gt-marine-robotics-group/Microtransat-PCB/AS5600_Mockup/AS5600_Mockup.step

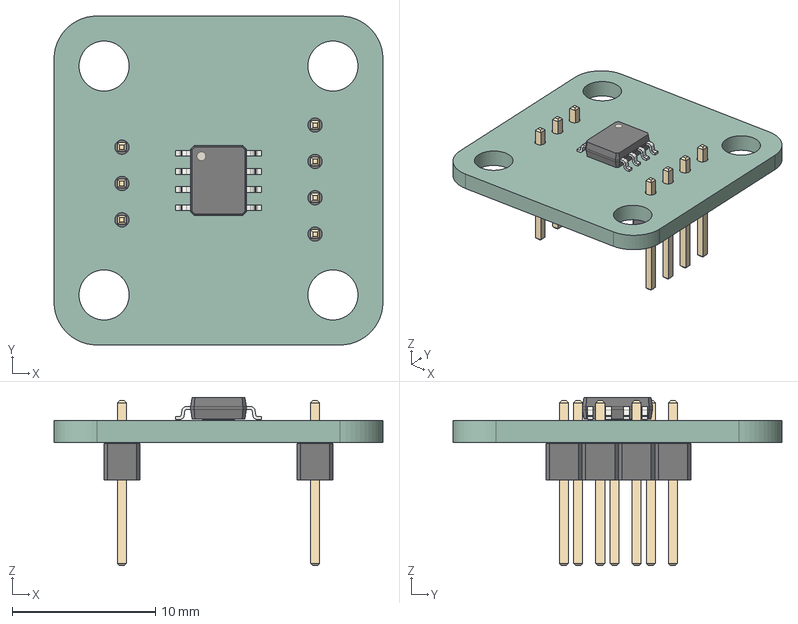
[picture p1: CAD file, 2026-02-19]
AS5600_Mockup/AS5600_Mockup.step
23.0 x 23.0 x 11.8 mm
SOIC-8-1EP_3.9x4.9mm_P1.27mm_EP2.29x3mm
PinHeader_1x04_P2.54mm_Vertical
PinHeader_1x03_P2.54mm_Vertical
AS5600_Mockup_PCB
