gt-marine-robotics-group/Microtransat-PCB/AS5600_Mockup/AS5600 Profile.dxf

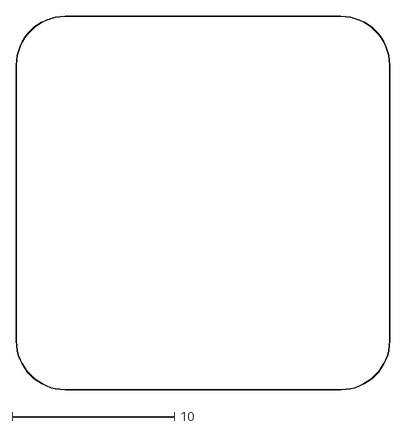
[picture p2: CAD file, 2026-02-19]
AS5600_Mockup/AS5600 Profile.dxf
23.0 x 23.0
