gt-marine-robotics-group/Microtransat-PCB/Microtransat_Schematic/Microtransat_Schematic.pdf

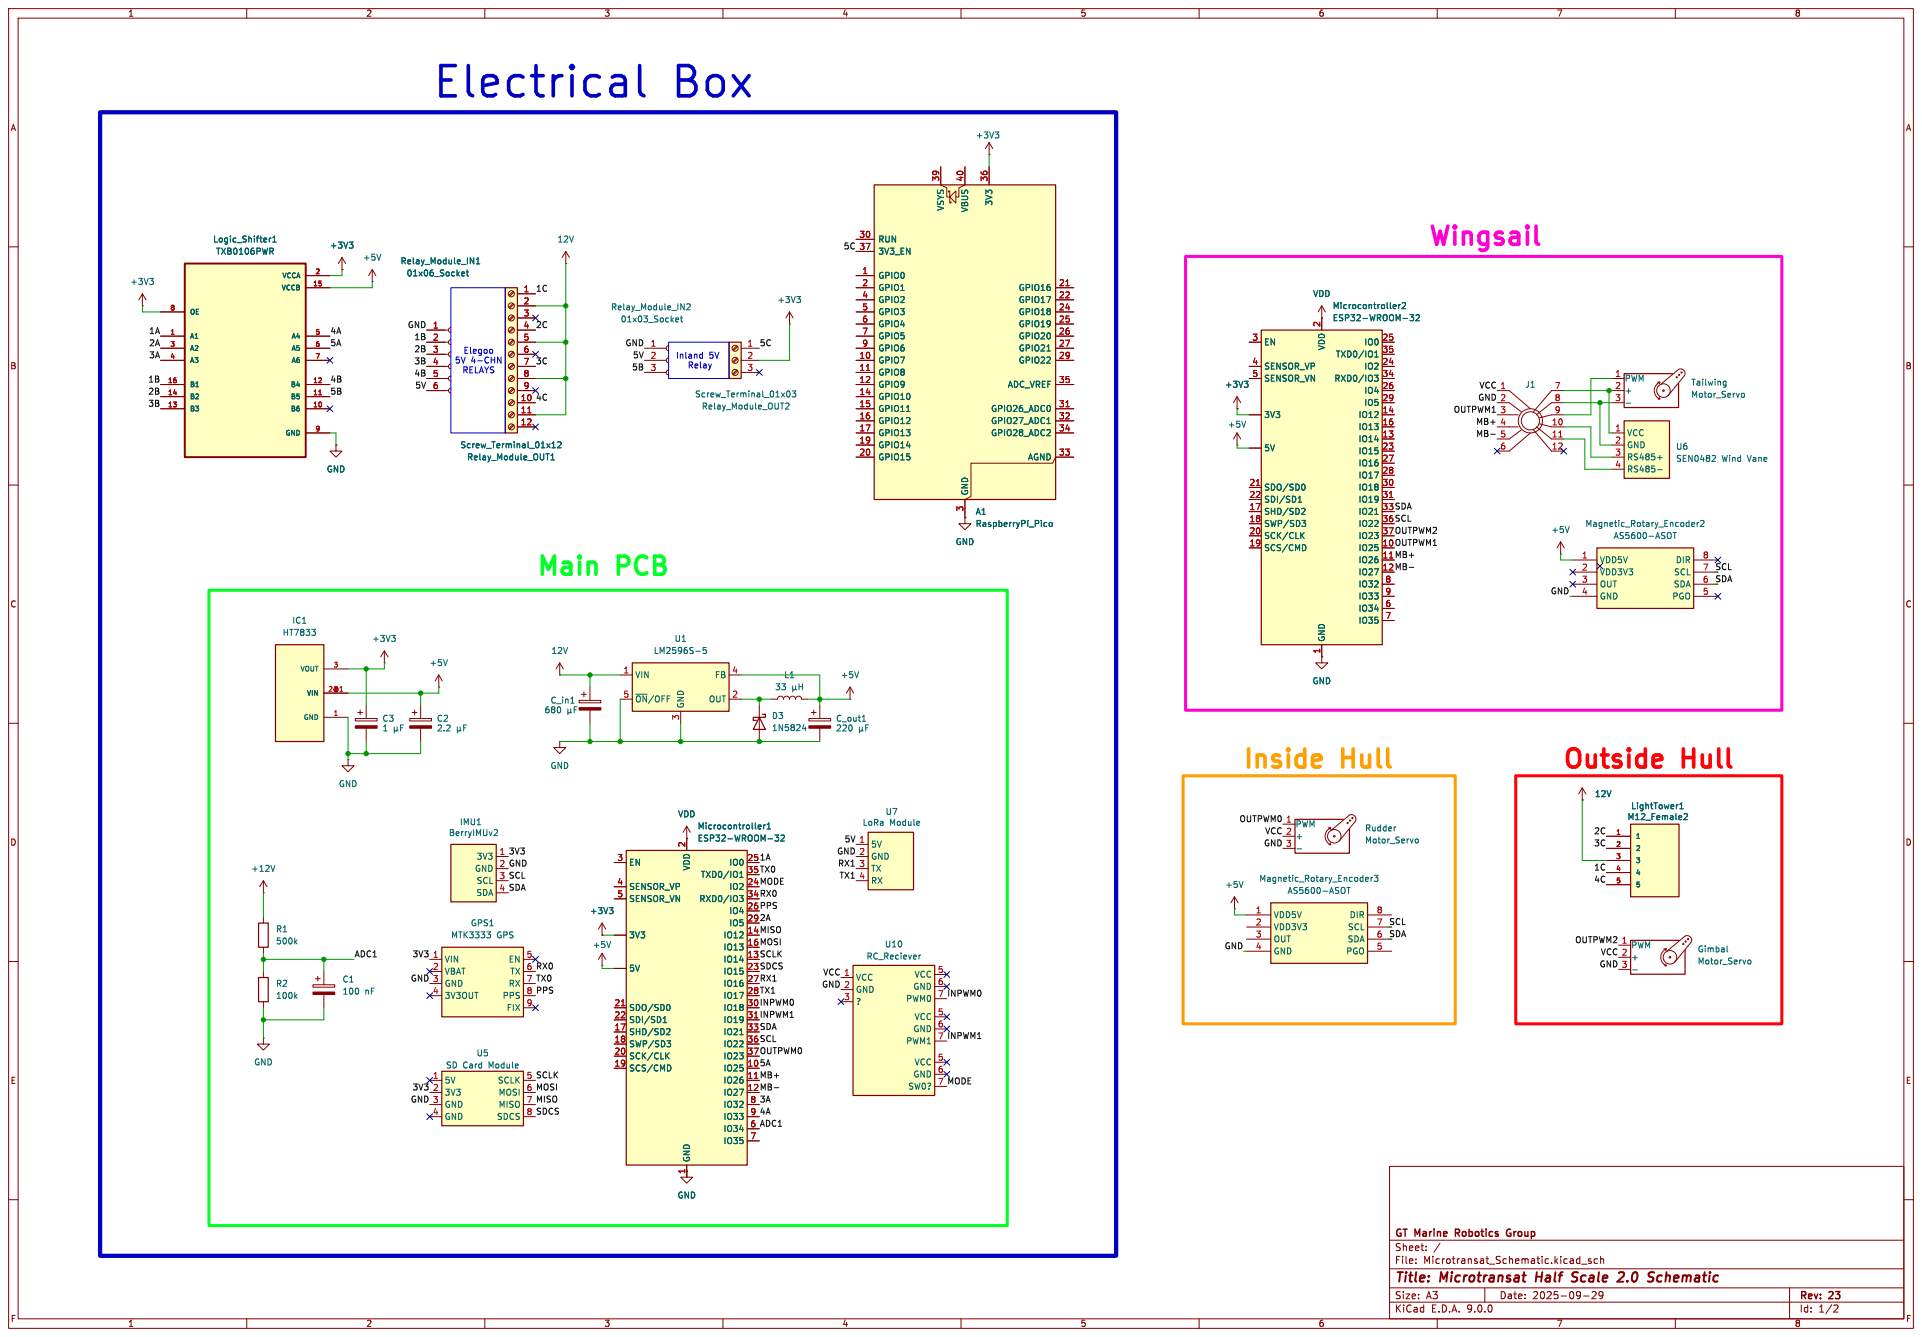
[picture p3: page 1]

Id: 1/2 Title: Microtransat Half Scale 2.0 Schematic
