gt-marine-robotics-group/Microtransat-PCB/Microtransat_mainboard/Microtransat_mainboard.kicad_pcb

## KiCad design Microtransat_mainboard/Microtransat_mainboard.kicad_pcb (2026-10-01)

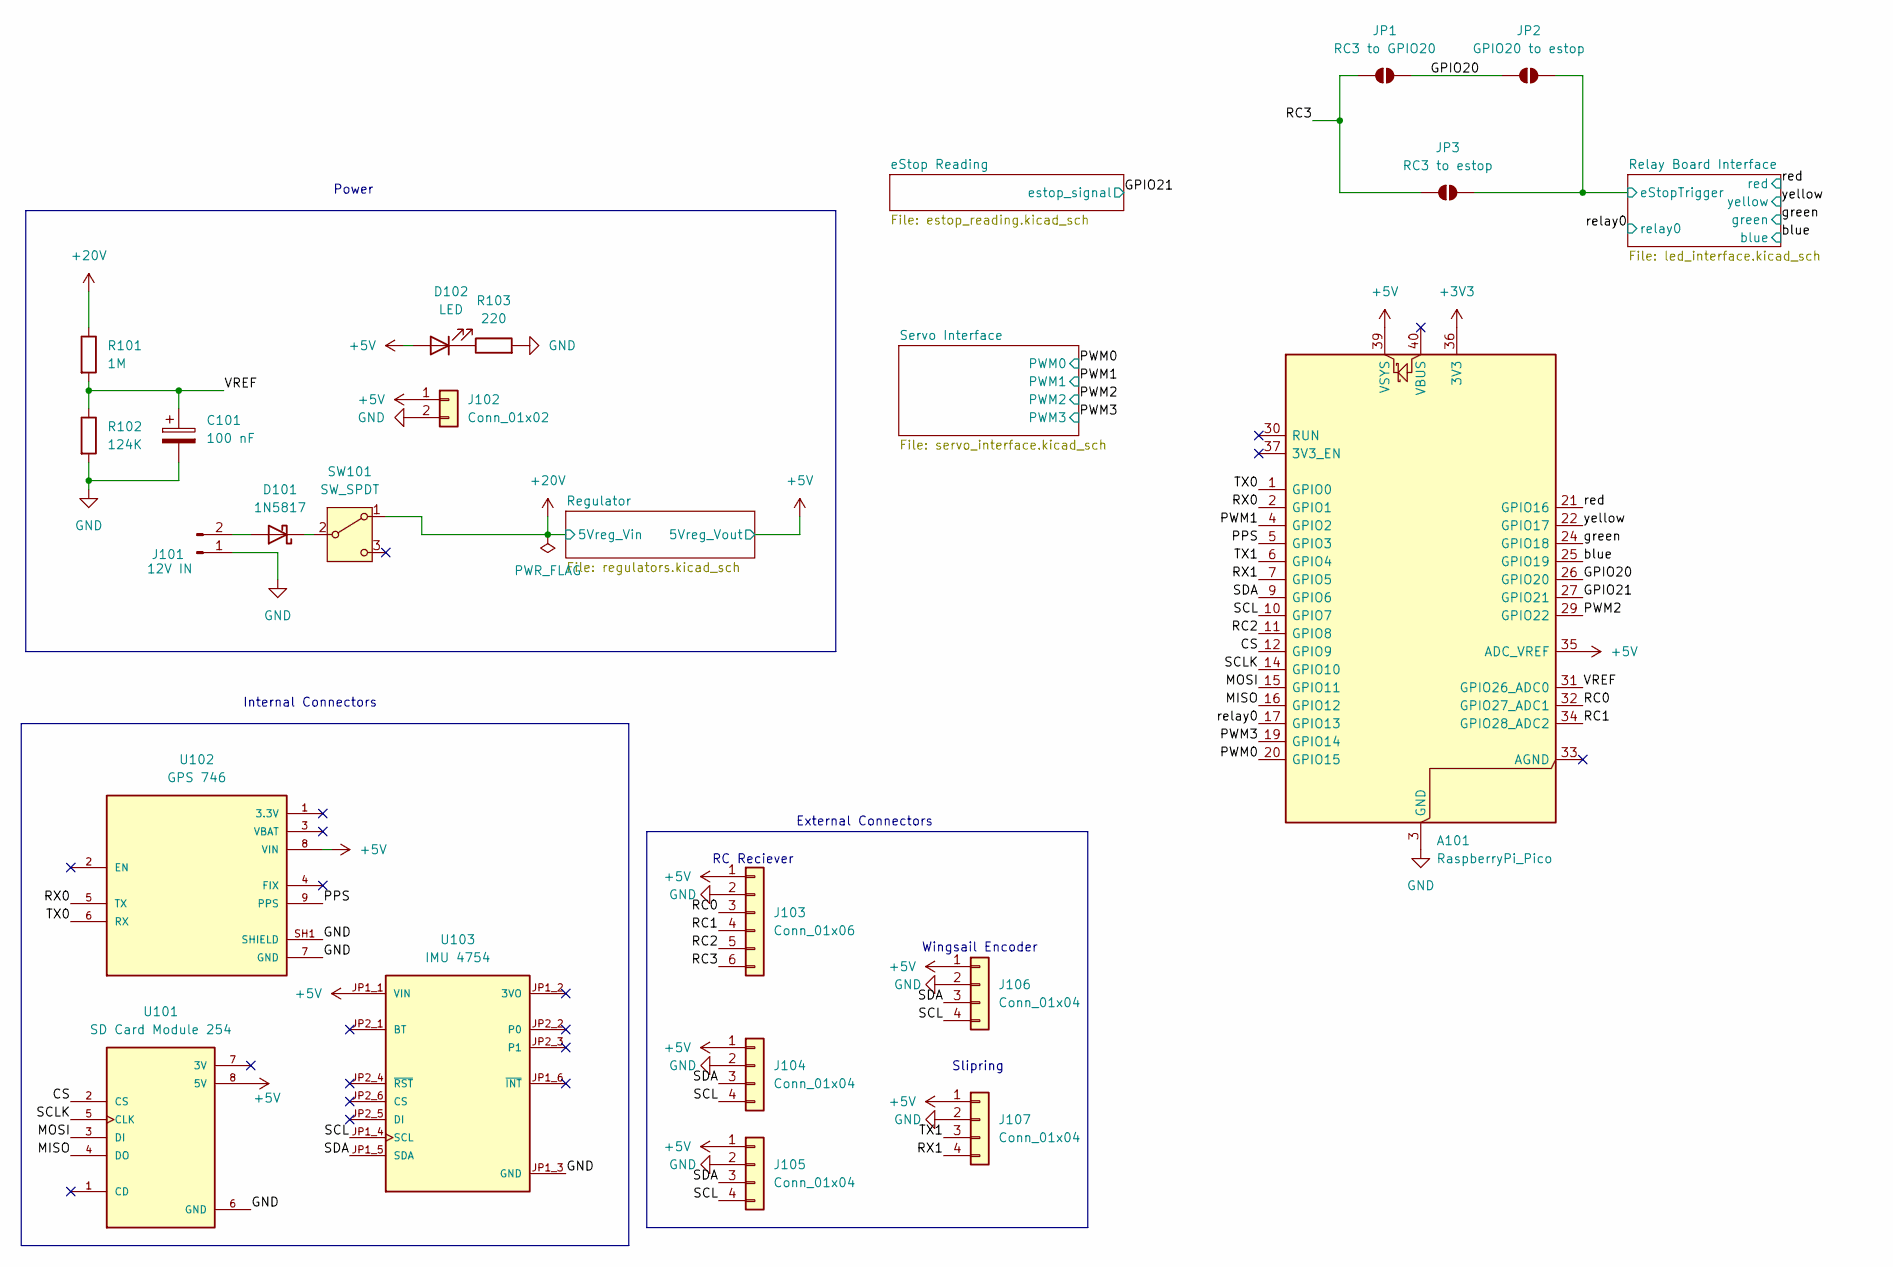
[picture p4: schematic Microtransat_mainboard.kicad_sch]

Parts:
A101: RaspberryPi_Pico; RaspberryPi_Pico_Common_Unspecified
C101: 100 nF; C_1206_3216Metric_Pad1.33x1.80mm_HandSolder
D101: 1N5817; D_DO-41_SOD81_P10.16mm_Horizontal
D102: LED; LED_1206_3216Metric_Pad1.42x1.75mm_HandSolder
J101: 12V IN; AMASS_XT30PW-M_1x02_P2.50mm_Horizontal
J102: Conn_01x02; JST_XH_B2B-XH-A_1x02_P2.50mm_Vertical
J103: Conn_01x06; JST_XH_B6B-XH-A_1x06_P2.50mm_Vertical
J104, J105, J106, J107: Conn_01x04; JST_XH_B4B-XH-A_1x04_P2.50mm_Vertical
JP1: RC3 to GPIO20; SolderJumper-2_P1.3mm_Open_RoundedPad1.0x1.5mm
JP2: GPIO20 to estop; SolderJumper-2_P1.3mm_Open_RoundedPad1.0x1.5mm
JP3: RC3 to estop; SolderJumper-2_P1.3mm_Open_RoundedPad1.0x1.5mm
R101: 1M; R_1206_3216Metric_Pad1.30x1.75mm_HandSolder
R102: 124K; R_1206_3216Metric_Pad1.30x1.75mm_HandSolder
R103: 220; R_1206_3216Metric_Pad1.30x1.75mm_HandSolder
SW101: SW_SPDT; SW_EG1218
U101: SD Card Module 254; MODULE_254; PARTREV Jul 31, 2013; DigiKey_Part_Number 1528-1462-ND
U102: GPS 746; XCVR_746; PARTREV 2022-12-01; DigiKey_Part_Number 1528-1153-ND
U103: IMU 4754; MODULE_4754; PARTREV 2021-03-16; DigiKey_Part_Number 1528-4754-ND

Connections:
+3V3: A101.36 (3V3); also elsewhere on the board
+5V: A101.35 (ADC_VREF), A101.39 (VSYS), D102.2 (A), J102.1, J103.1, J104.1, J105.1, J106.1, J107.1, U101.8 (5V), U102.8 (VIN), U103.JP1_1 (VIN); also elsewhere on the board
+20V: R101.1, SW101.1 (A); also elsewhere on the board
/CS: A101.12 (GPIO9), U101.2 (CS)
/GPIO20: A101.26 (GPIO20), JP1.2 (B), JP2.1 (A)
/GPIO21: A101.27 (GPIO21); also elsewhere on the board
/MISO: A101.16 (GPIO12), U101.4 (DO)
/MOSI: A101.15 (GPIO11), U101.3 (DI)
/PPS: A101.5 (GPIO3), U102.9 (PPS)
/PWM0: A101.20 (GPIO15); also elsewhere on the board
/PWM1: A101.4 (GPIO2); also elsewhere on the board
/PWM2: A101.29 (GPIO22); also elsewhere on the board
/PWM3: A101.19 (GPIO14); also elsewhere on the board
/RC0: A101.32 (GPIO27_ADC1), J103.3
/RC1: A101.34 (GPIO28_ADC2), J103.4
/RC2: A101.11 (GPIO8), J103.5
/RC3: J103.6, JP1.1 (A), JP3.1 (A)
/RX0: A101.2 (GPIO1), U102.5 (TX)
/RX1: A101.7 (GPIO5), J107.4
/Relay Board Interface/eStopTrigger: JP2.2 (B), JP3.2 (B); also elsewhere on the board
/SCL: A101.10 (GPIO7), J104.4, J105.4, J106.4, U103.JP1_4 (SCL)
/SCLK: A101.14 (GPIO10), U101.5 (CLK)
/SDA: A101.9 (GPIO6), J104.3, J105.3, J106.3, U103.JP1_5 (SDA)
/TX0: A101.1 (GPIO0), U102.6 (RX)
/TX1: A101.6 (GPIO4), J107.3
/VREF: A101.31 (GPIO26_ADC0), C101.1, R101.2, R102.1
/blue: A101.25 (GPIO19); also elsewhere on the board
/green: A101.24 (GPIO18); also elsewhere on the board
/red: A101.21 (GPIO16); also elsewhere on the board
/relay0: A101.17 (GPIO13); also elsewhere on the board
/yellow: A101.22 (GPIO17); also elsewhere on the board
GND: A101.3 (GND), A101.8 (GND), A101.13 (GND), A101.18 (GND), A101.23 (GND), A101.28 (GND), A101.38 (GND), C101.2, J101.1, J102.2, J103.2, J104.2, J105.2, J106.2, J107.2, R102.2, R103.2, U101.6 (GND), U102.7 (GND), U102.SH1 (SHIELD), U102.SH2 (SHIELD), U103.JP1_3 (GND); also elsewhere on the board
unnamed: D101.2 (A), J101.2
unnamed: D101.1 (K), SW101.2 (B)
unnamed: D102.1 (K), R103.1

Notes on the sheet:
Wingsail Encoder
Internal Connectors
Power
Slipring
RC Reciever
External Connectors

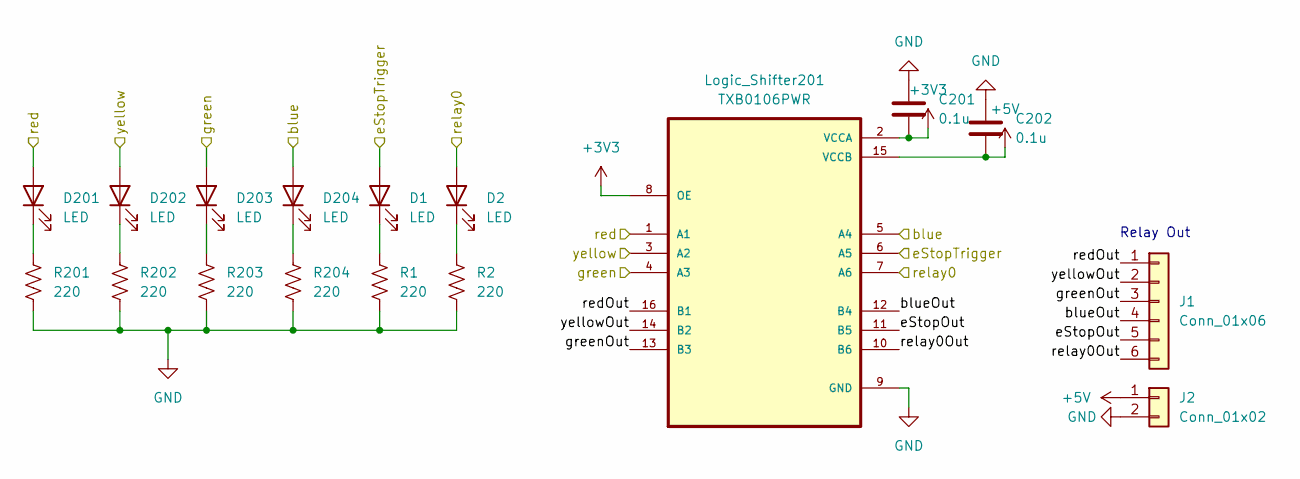
[picture p5: schematic led_interface.kicad_sch]

Parts:
C201, C202: 0.1u; C_1206_3216Metric_Pad1.33x1.80mm_HandSolder
D1, D2, D201, D202, D203, D204: LED; LED_1206_3216Metric_Pad1.42x1.75mm_HandSolder
J1: Conn_01x06; JST_XH_B6B-XH-A_1x06_P2.50mm_Vertical
J2: Conn_01x02; JST_XH_B2B-XH-A_1x02_P2.50mm_Vertical
Logic_Shifter201: TXB0106PWR; SOP65P640X120-16N
R1, R2, R201, R202, R203, R204: 220; R_1206_3216Metric_Pad1.30x1.75mm_HandSolder

Connections:
+3V3: C201.1, Logic_Shifter201.2 (VCCA), Logic_Shifter201.8 (OE); also elsewhere on the board
+5V: C202.1, J2.1, Logic_Shifter201.15 (VCCB); also elsewhere on the board
/Relay Board Interface/blueOut: J1.4, Logic_Shifter201.12 (B4)
/Relay Board Interface/eStopOut: J1.5, Logic_Shifter201.11 (B5)
/Relay Board Interface/eStopTrigger: D1.2 (A), Logic_Shifter201.6 (A5); also elsewhere on the board
/Relay Board Interface/greenOut: J1.3, Logic_Shifter201.13 (B3)
/Relay Board Interface/redOut: J1.1, Logic_Shifter201.16 (B1)
/Relay Board Interface/relay0Out: J1.6, Logic_Shifter201.10 (B6)
/Relay Board Interface/yellowOut: J1.2, Logic_Shifter201.14 (B2)
/blue: D204.2 (A), Logic_Shifter201.5 (A4); also elsewhere on the board
/green: D203.2 (A), Logic_Shifter201.4 (A3); also elsewhere on the board
/red: D201.2 (A), Logic_Shifter201.1 (A1); also elsewhere on the board
/relay0: D2.2 (A), Logic_Shifter201.7 (A6); also elsewhere on the board
/yellow: D202.2 (A), Logic_Shifter201.3 (A2); also elsewhere on the board
GND: C201.2, C202.2, J2.2, Logic_Shifter201.9 (GND), R1.2, R2.2, R201.2, R202.2, R203.2, R204.2; also elsewhere on the board
unnamed: D1.1 (K), R1.1
unnamed: D2.1 (K), R2.1
unnamed: D201.1 (K), R201.1
unnamed: D202.1 (K), R202.1
unnamed: D203.1 (K), R203.1
unnamed: D204.1 (K), R204.1

Notes on the sheet:
Relay Out

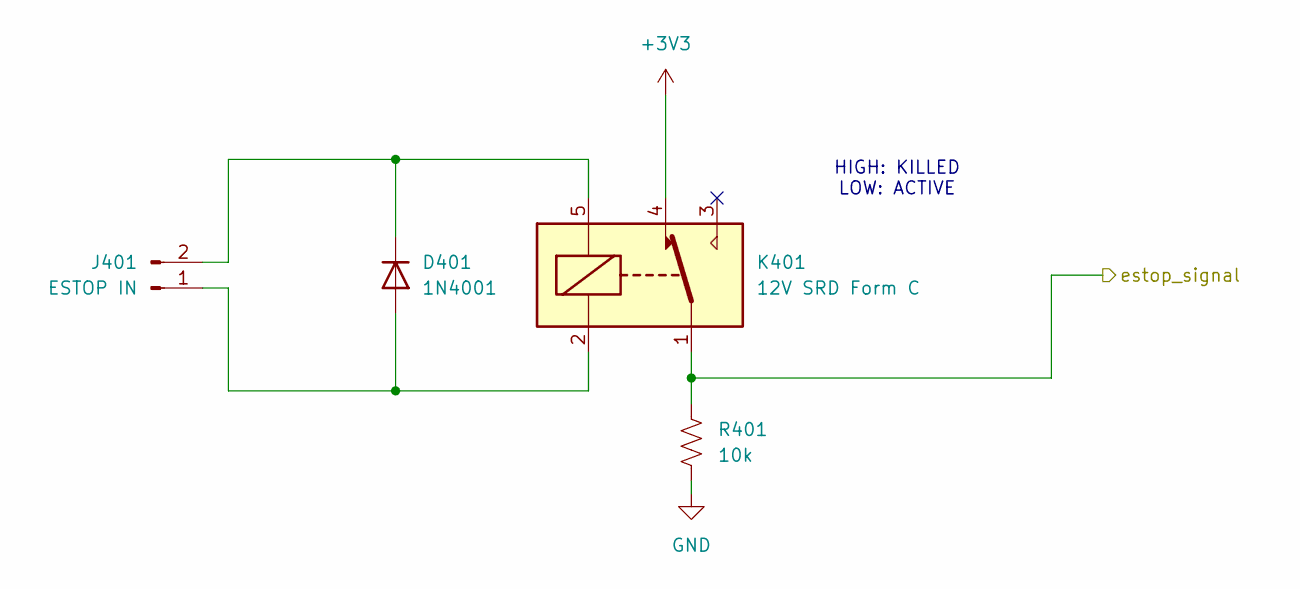
[picture p6: schematic estop_reading.kicad_sch]

Parts:
D401: 1N4001; D_DO-41_SOD81_P10.16mm_Horizontal
J401: ESTOP IN; AMASS_XT30PW-M_1x02_P2.50mm_Horizontal
K401: 12V SRD Form C; Relay_SPDT_SANYOU_SRD_Series_Form_C
R401: 10k; R_1206_3216Metric_Pad1.30x1.75mm_HandSolder

Connections:
+3V3: K401.4; also elsewhere on the board
/GPIO21: K401.1, R401.1; also elsewhere on the board
GND: R401.2; also elsewhere on the board
unnamed: D401.2 (A), J401.1, K401.2
unnamed: D401.1 (K), J401.2, K401.5

Notes on the sheet:
HIGH: KILLED LOW: ACTIVE

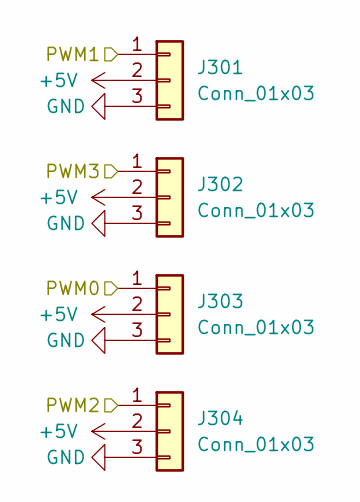
[picture p7: schematic servo_interface.kicad_sch]

Parts:
J301, J302, J303, J304: Conn_01x03; JST_XH_B3B-XH-A_1x03_P2.50mm_Vertical

Connections:
+5V: J301.2, J302.2, J303.2, J304.2; also elsewhere on the board
/PWM0: J303.1; also elsewhere on the board
/PWM1: J301.1; also elsewhere on the board
/PWM2: J304.1; also elsewhere on the board
/PWM3: J302.1; also elsewhere on the board
GND: J301.3, J302.3, J303.3, J304.3; also elsewhere on the board

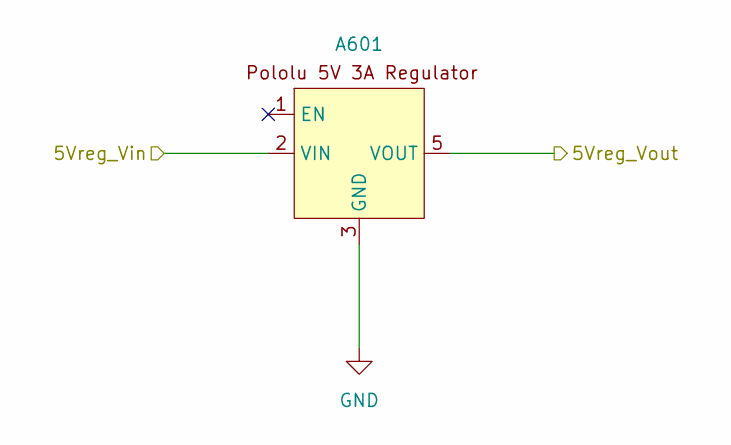
[picture p8: schematic regulators.kicad_sch]

Parts:
A601: Pololu 5V 3A Regulator

Connections:
+5V: A601.5 (VOUT); also elsewhere on the board
+20V: A601.2 (VIN); also elsewhere on the board
GND: A601.3 (GND), A601.4 (GND); also elsewhere on the board

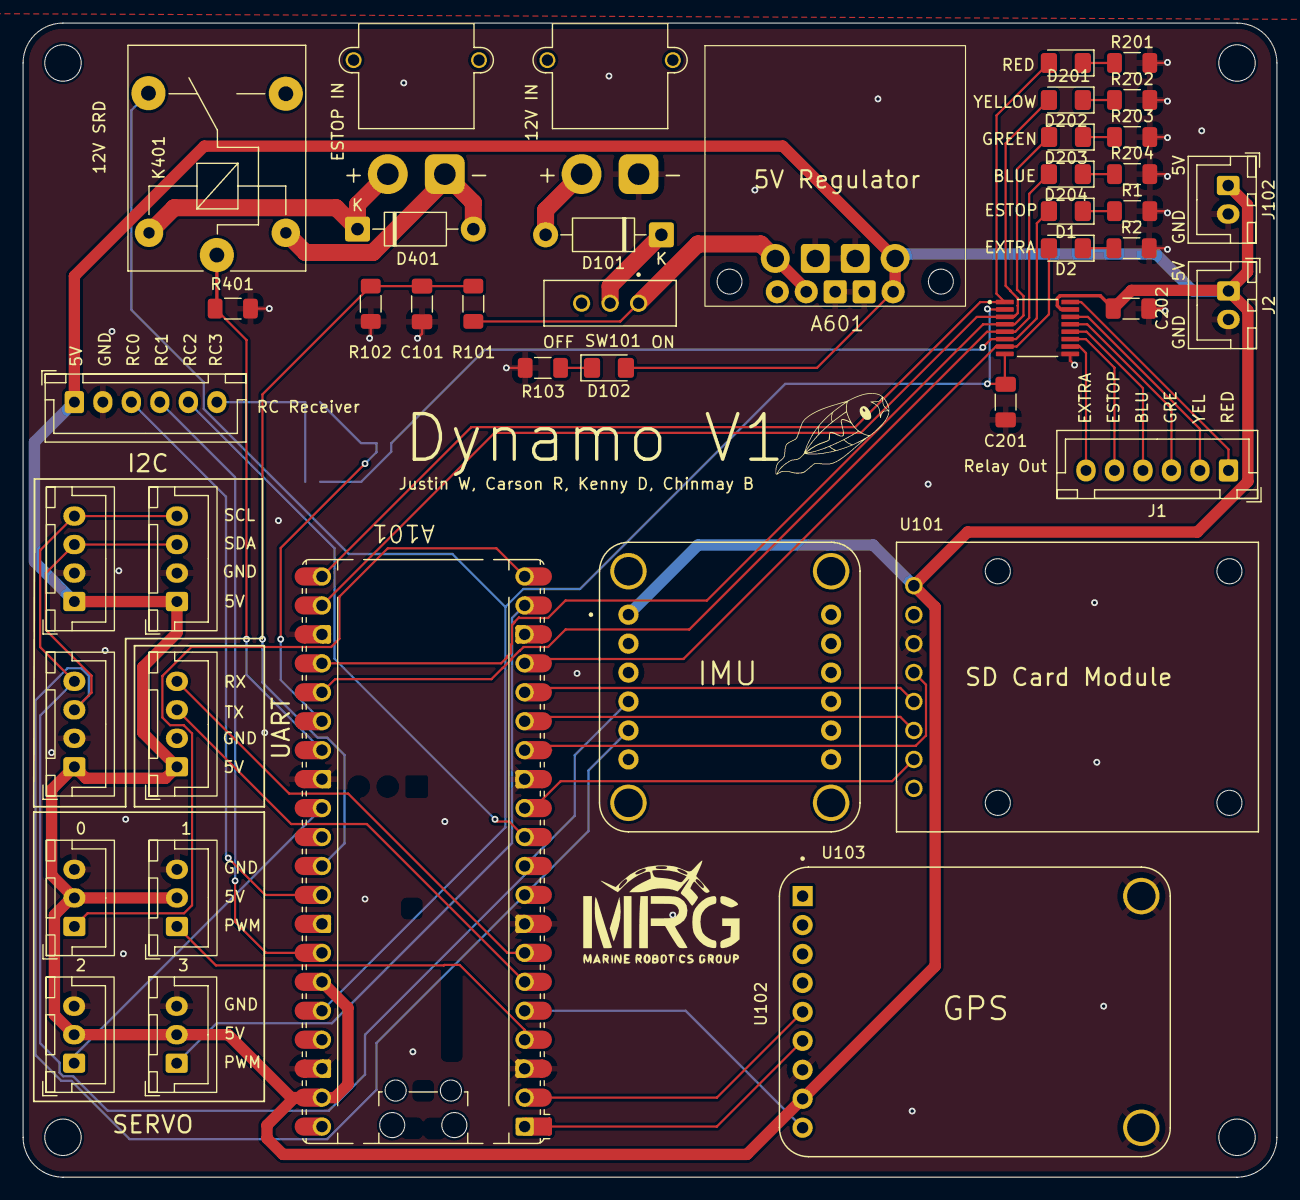
[picture p9: board Microtransat_mainboard.kicad_pcb from above]

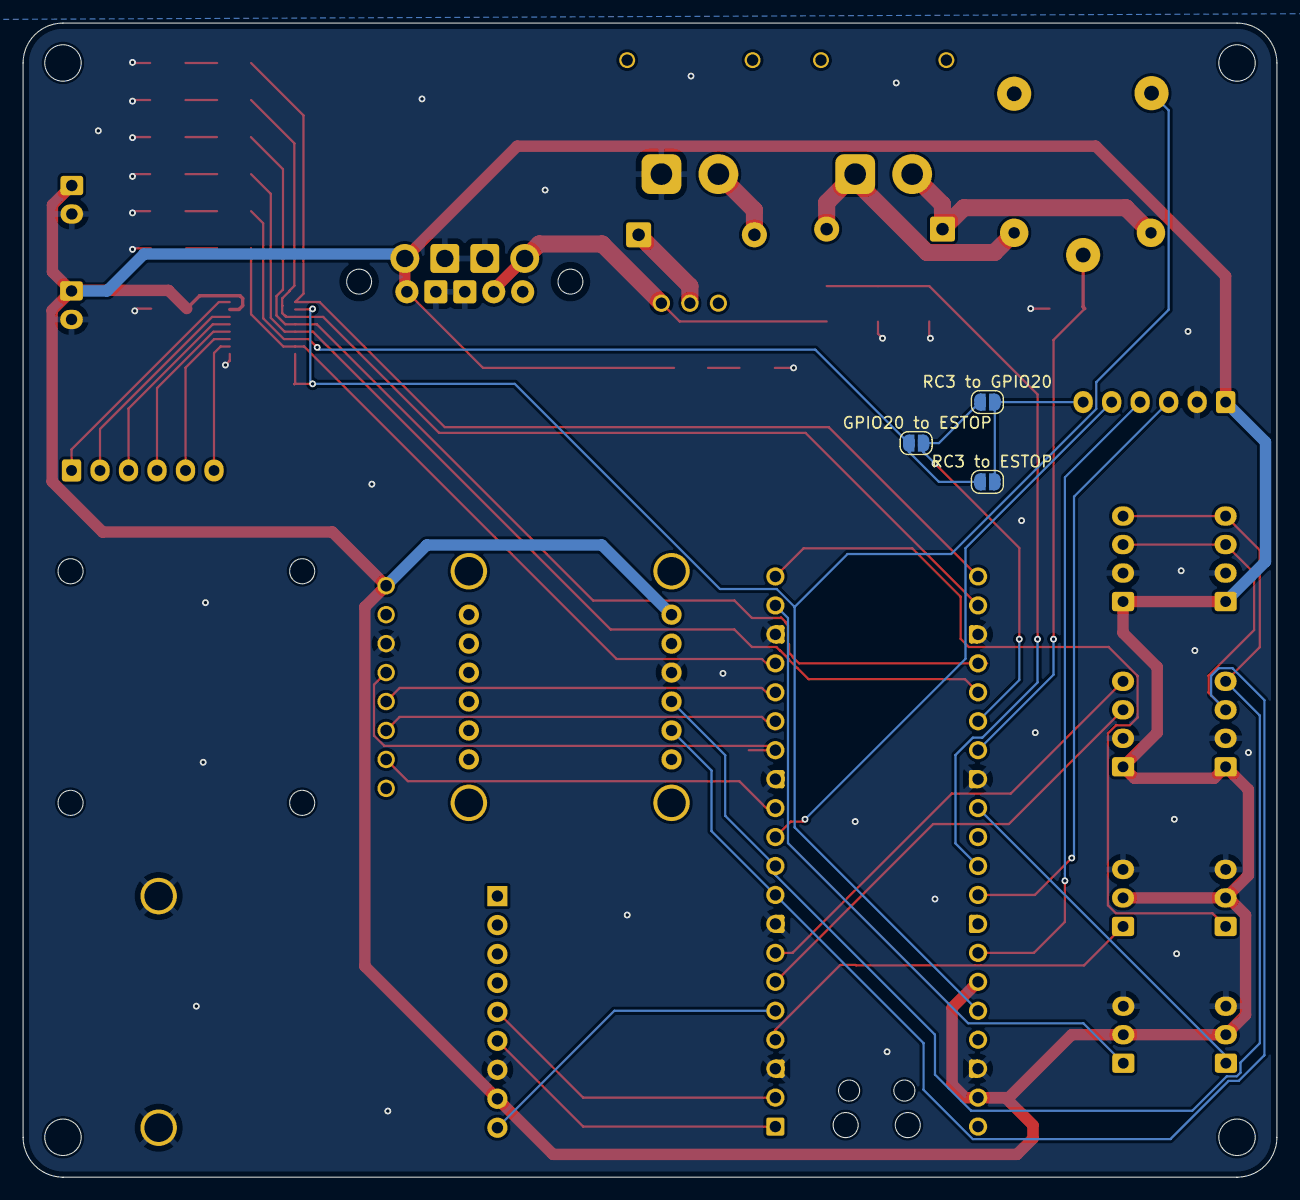
[picture p10: board Microtransat_mainboard.kicad_pcb from below]

Board: 2 copper layers, 110.0 x 101.2 mm, 47 parts (3 on the bottom side), 49 nets.
