gt-marine-robotics-group/Microtransat-PCB/(commit log)

2026-02-07 Added in work on overall boat schematic
    [Microtransat_Schematic.kicad_pcb, Microtransat_Schematic.kicad_sch, TXB0106PWR.step, penetrators.kicad_sch]
2026-02-07 Added basic schematic for mainboard
    [Microtransat_mainboard.kicad_pcb, Microtransat_mainboard.kicad_sch]
2026-02-19 Added AS5600 mockup
    [AS5600 Profile.dxf, AS5600_Mockup.kicad_pcb, AS5600_Mockup.kicad_sch, AS5600_Mockup.step, Microtransat_Schematic.kicad_sch, Microtransat_mainboard.kicad_sch]
2026-02-21 Removed some old/incorrect stuff
    [Microtransat_Schematic.kicad_sch]
2026-02-23 Some adjustments
    [Microtransat_mainboard.kicad_sch]
2026-02-28 Added SD card footprint
    [Microtransat_Schematic.kicad_sch]
2026-02-28 Moved symbol and footprint into libraries folder
    [Microtransat_mainboard.kicad_sch, TXB0106PWR.step]
2026-02-28 Fixed up mainboard schematic
    [Microtransat_mainboard.kicad_sch]
2026-03-01 Readding footprints for GPS + IMU
2026-03-01 Updated IMU symbol
    V2 -> V3 SPI
    [Microtransat_mainboard.kicad_sch]
2026-03-01 Fixed library paths to project environment variable
    [Microtransat_mainboard.kicad_sch]
2026-03-07 added led and servo interface
    [Microtransat_mainboard.kicad_sch, led_interface.kicad_sch, servo_interface.kicad_sch]
2026-03-07 Fixed merge error
    [Microtransat_mainboard.kicad_sch]
2026-03-07 add estop stuff kinda
    [Microtransat_mainboard.kicad_sch, estop_reading.kicad_sch, estop_trigger.kicad_sch, led_interface.kicad_sch]
2026-03-07 Deleting presto board
    [estop_reading.kicad_sch, estop_trigger.kicad_sch, led_interface.kicad_sch, presto.kicad_pcb, presto.kicad_sch, rc_interface.kicad_sch, regulators.kicad_sch, servo_interface.kicad_sch]
2026-03-07 Added new IMU to the schematic + new PWM
    [Microtransat_mainboard.kicad_sch, servo_interface.kicad_sch]
2026-03-07 Added BNO085 IMU libraries
2026-03-07 Stole footprints for RC Switch and Regulator
2026-03-07 Added regulators and updated GPS, IMU, SD Card symbols
    [Microtransat_mainboard.kicad_sch, estop_trigger.kicad_sch, regulators.kicad_sch]
2026-03-07 Fixed ERC errors
    [Microtransat_mainboard.kicad_sch, led_interface.kicad_sch, servo_interface.kicad_sch]
2026-03-07 Added switch
    [Microtransat_mainboard.kicad_sch, estop_trigger.kicad_sch, regulators.kicad_sch]
2026-03-07 Updated footprints
    [Microtransat_mainboard.kicad_pcb, Microtransat_mainboard.kicad_sch, servo_interface.kicad_sch]
2026-03-07 update resistor
    [estop_reading.kicad_sch]
2026-03-07 Started PCB
    [Microtransat_mainboard.kicad_pcb, Microtransat_mainboard.kicad_sch]
2026-03-07 Added power connector for raspberry pi
    [Microtransat_mainboard.kicad_pcb, Microtransat_mainboard.kicad_sch]
2026-03-13 Added second RC switch for mode pin, added additional relay output, changed IMU to I2C
    [Microtransat_mainboard.kicad_pcb, Microtransat_mainboard.kicad_sch, led_interface.kicad_sch, mode_switch.kicad_sch]
2026-03-14 moved pcb around
    [Microtransat_mainboard.kicad_pcb]
2026-03-14 we did our best...
    [Microtransat_mainboard.kicad_pcb]
2026-04-04 routed the traces (maybe?)
    [Microtransat_mainboard.kicad_pcb, led_interface.kicad_sch]
2026-04-08 DRC passing
    [Microtransat_mainboard.kicad_pcb]
2026-04-08 Fixed RC Receiver pin header
    [Microtransat_mainboard.kicad_pcb, Microtransat_mainboard.kicad_sch]
2026-04-09 Updated PCB silkscreen
    [Microtransat_mainboard.kicad_pcb]
2026-04-09 Finished silkscreen/outline changes
    [Microtransat_mainboard.kicad_pcb, Microtransat_mainboard.kicad_sch, estop_reading.kicad_sch, estop_trigger.kicad_sch, led_interface.kicad_sch, mode_switch.kicad_sch, regulators.kicad_sch, servo_interface.kicad_sch]
2026-04-10 Some small changes to silkscreen and component numbers
    [Microtransat_mainboard.kicad_pcb, Microtransat_mainboard.kicad_sch, estop_reading.kicad_sch, estop_trigger.kicad_sch, led_interface.kicad_sch, mode_switch.kicad_sch, regulators.kicad_sch, servo_interface.kicad_sch]
2026-04-10 Fixed changes from design review
    [Microtransat_mainboard.kicad_pcb, Microtransat_mainboard.kicad_sch, estop_trigger.kicad_sch, led_interface.kicad_sch, mode_switch.kicad_sch]
2026-05-19 Exported production files
    [Microtransat_mainboard-B_Cu.gbr, Microtransat_mainboard-B_Mask.gbr, Microtransat_mainboard-B_Paste.gbr, Microtransat_mainboard-B_Silkscreen.gbr, Microtransat_mainboard-Edge_Cuts.gbr, Microtransat_mainboard-F_Cu.gbr, Microtransat_mainboard-F_Mask.gbr, Microtransat_mainboard-F_Paste.gbr]
2026-09-16 Used correct battery voltage ~20V
    [Microtransat_mainboard.kicad_sch]
2026-10-01 Fixed voltage divider/high power voltage
    [Microtransat_mainboard.kicad_pcb, Microtransat_mainboard.kicad_sch]
